WB2CBA/QO100-PORTABLE-TRANSCEIVER-PROJECT/QO100 PA/QO100_PA.kicad_pcb

## KiCad design QO100 PA/QO100_PA.kicad_pcb (2024-05-10)

Schematic: QO100_PA.sch, N3B QO100 TRX PA + PSU

Parts:
C1: 100uF/50V; CP_Elec_6.3x7.7
C2: 1000uF/16V; CP_Elec_10x10.5
D1, D3: SS34; D_SMA
D2: PWR; LED_D3.0mm
H1, H2, H3, H4: MountingHole_Pad; MountingHole_3.2mm_M3_DIN965_Pad
J1: PATCH01; PinHeader_1x20_P2.54mm_Vertical
J2: PATCH02; PinHeader_1x20_P2.54mm_Vertical
J3: PJ-102A; Barrel_Jack_5.5mmODx2.1mmID_PJ-102A; MPN PJ-102A; Digi-Key_PN CP-102A-ND
J4: EDUP PWR; PinHeader_1x02_P2.54mm_Vertical
L1: 100uH; L_Bourns-SRN8040_8x8.15mm-MOD
R1: 1k; R_0805_2012Metric
SW1: POWER SW; EG1206
U1: SKY65135Module; SKY65135_MODULE
U2: LM2576S-5; TO-263-5_TabPin3

Connections:
+5V: C2.1, J1.9, L1.2, U1.2, U1.3, U2.4 (FB)
+12V: C1.1, J1.8, J4.1, R1.1, SW1.2 (B), U2.1 (VIN)
GNDPWR: C1.2, C2.2, D2.1 (K), D3.2 (A), H1.1, H2.1, H3.1, H4.1, J1.18, J1.19, J1.20, J2.18, J2.19, J2.20, J3.2, J3.3, J4.2, U1.4, U1.5, U1.6, U2.3 (GND), U2.5 (~ON~/OFF)
unnamed: D1.1 (K), SW1.3 (C)
unnamed: D1.2 (A), J3.1
unnamed: D2.2 (A), R1.2
unnamed: D3.1 (K), L1.1, U2.2 (OUT)

Notes on the sheet:
PSU Unit

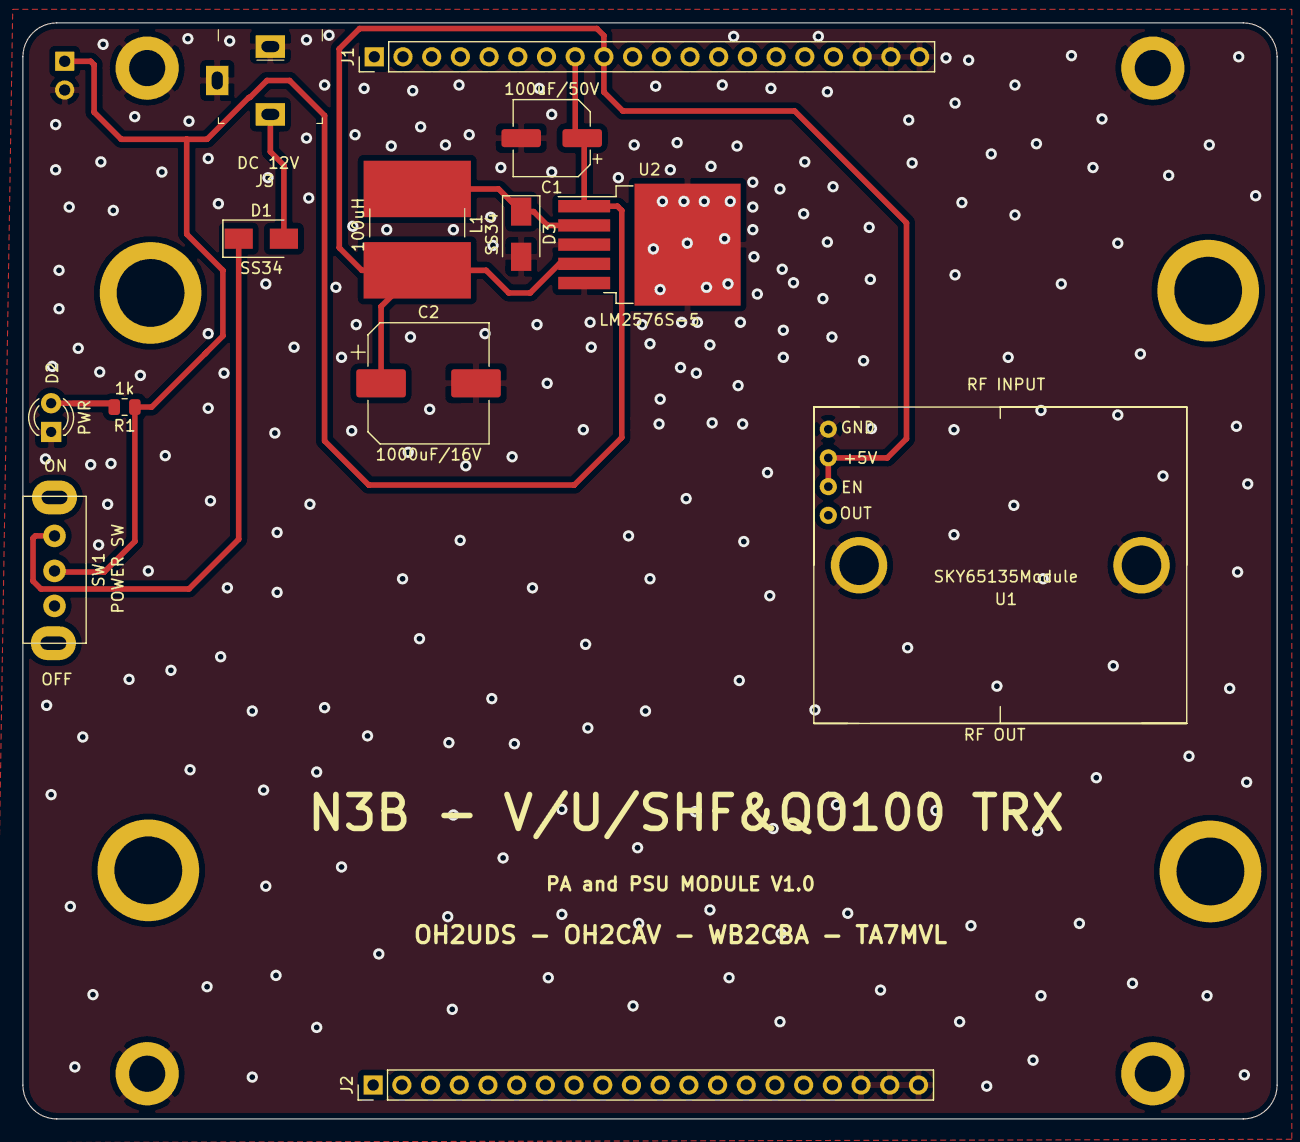
[picture p1: board QO100_PA.kicad_pcb from above]

Board: 2 copper layers, 111.0 x 97.0 mm, 18 parts (1 on the bottom side), 7 nets.
