WB2CBA/QO100-PORTABLE-TRANSCEIVER-PROJECT/QO100 RX MODULE/QO100_RX.kicad_pcb

## KiCad design QO100 RX MODULE/QO100_RX.kicad_pcb (2024-04-22)

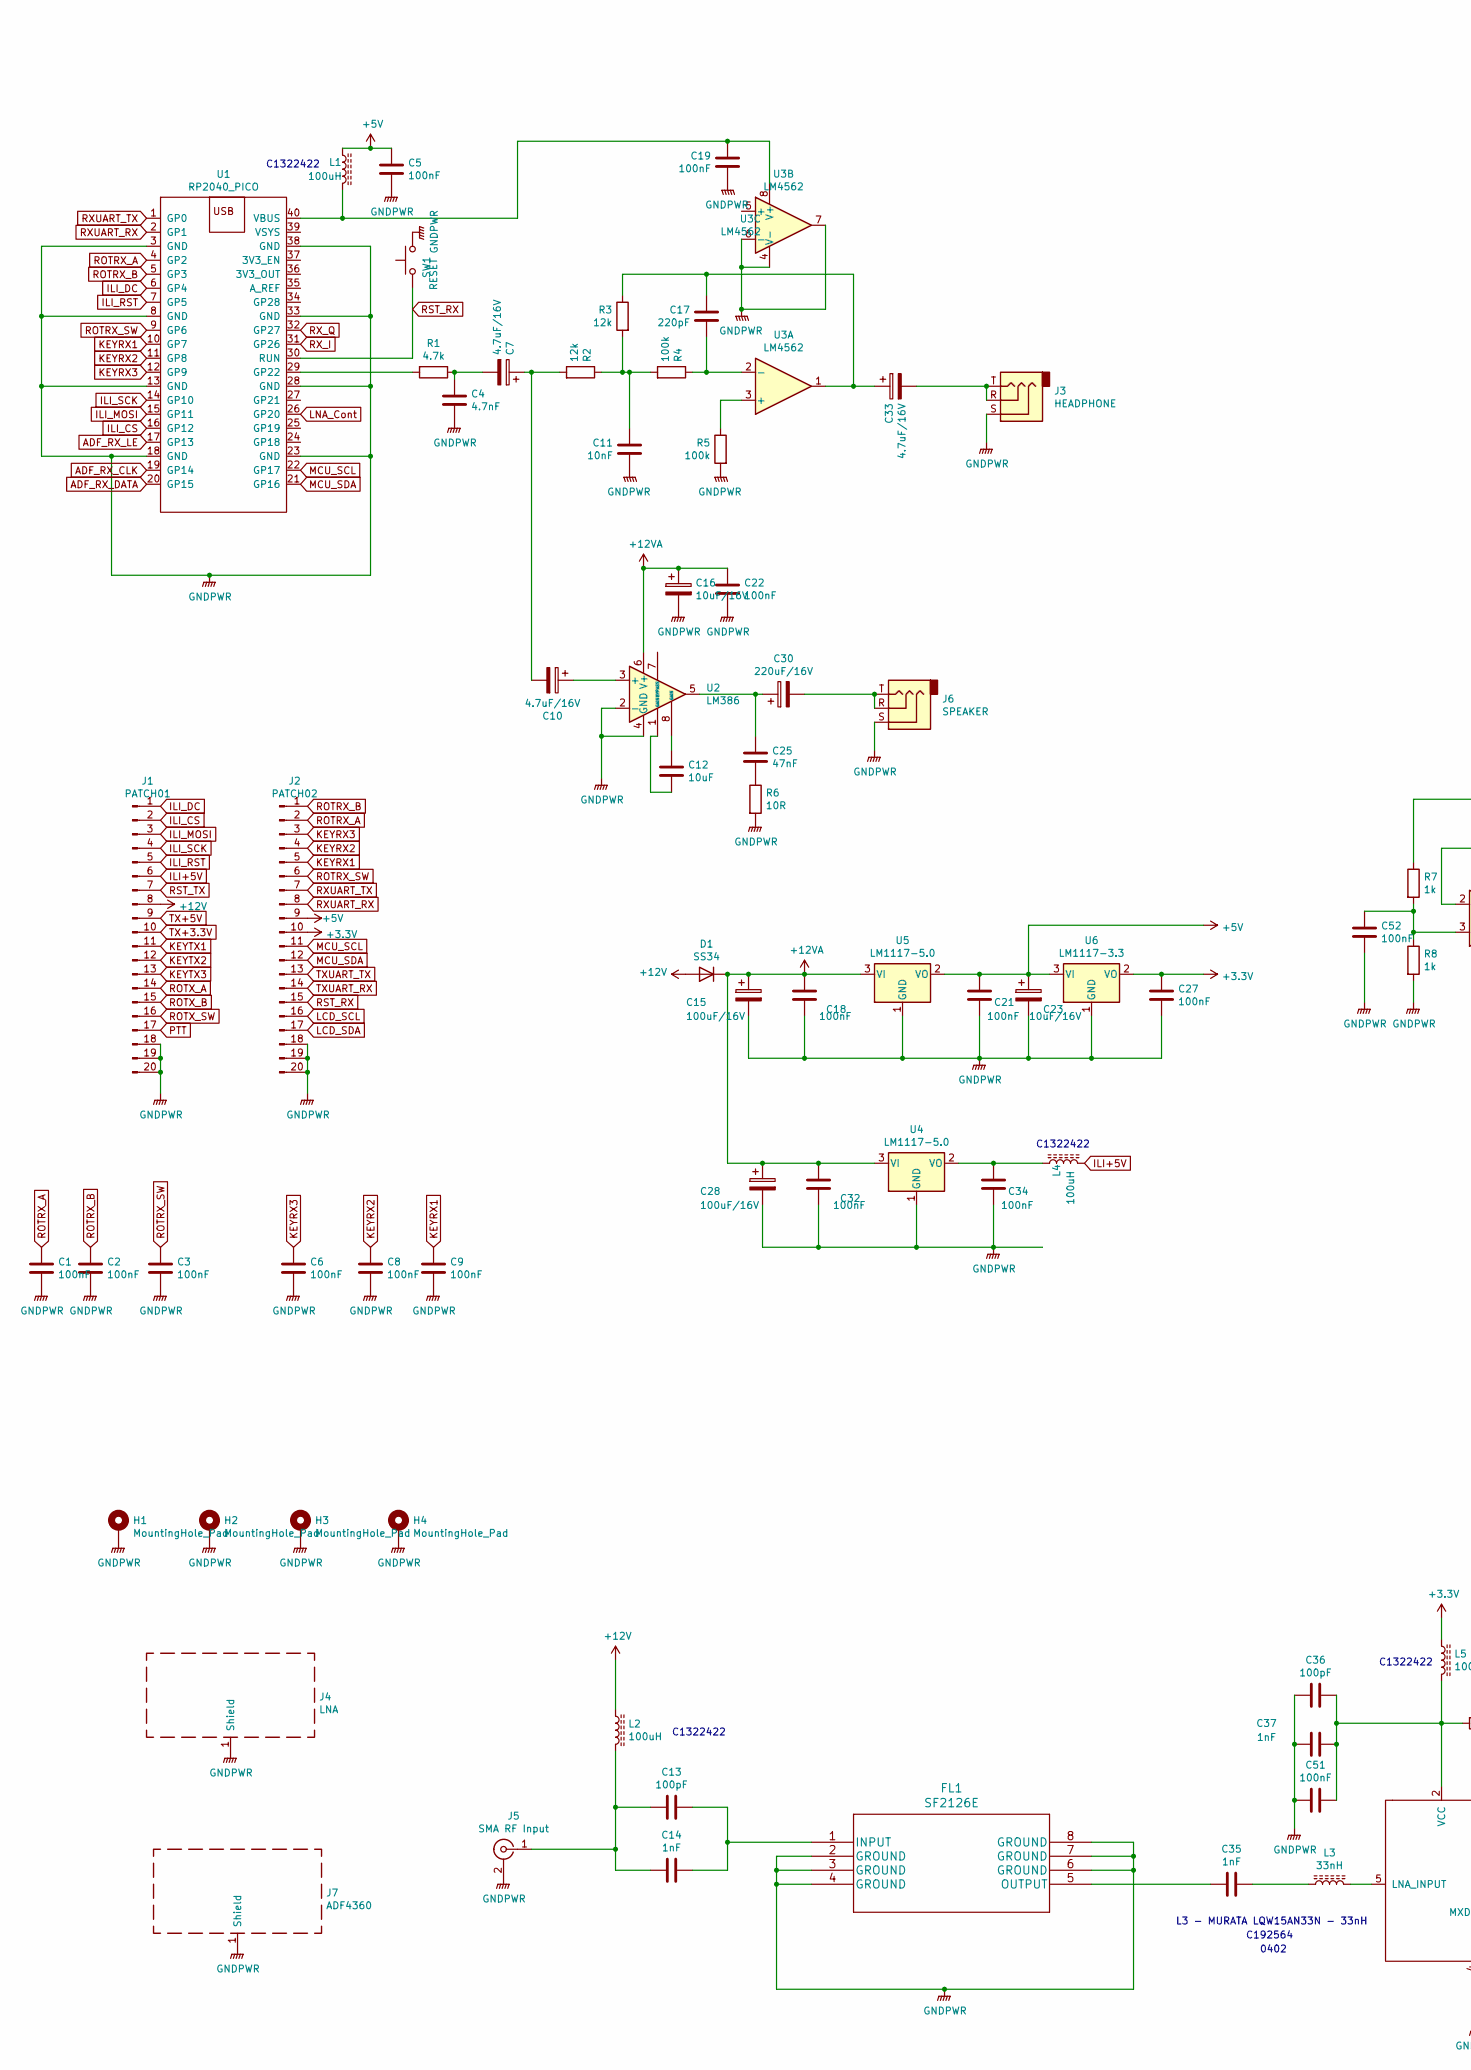
[picture p2: schematic QO100_RX.sch, N3B QO100 RX MODULE, part in row 1, column 1]

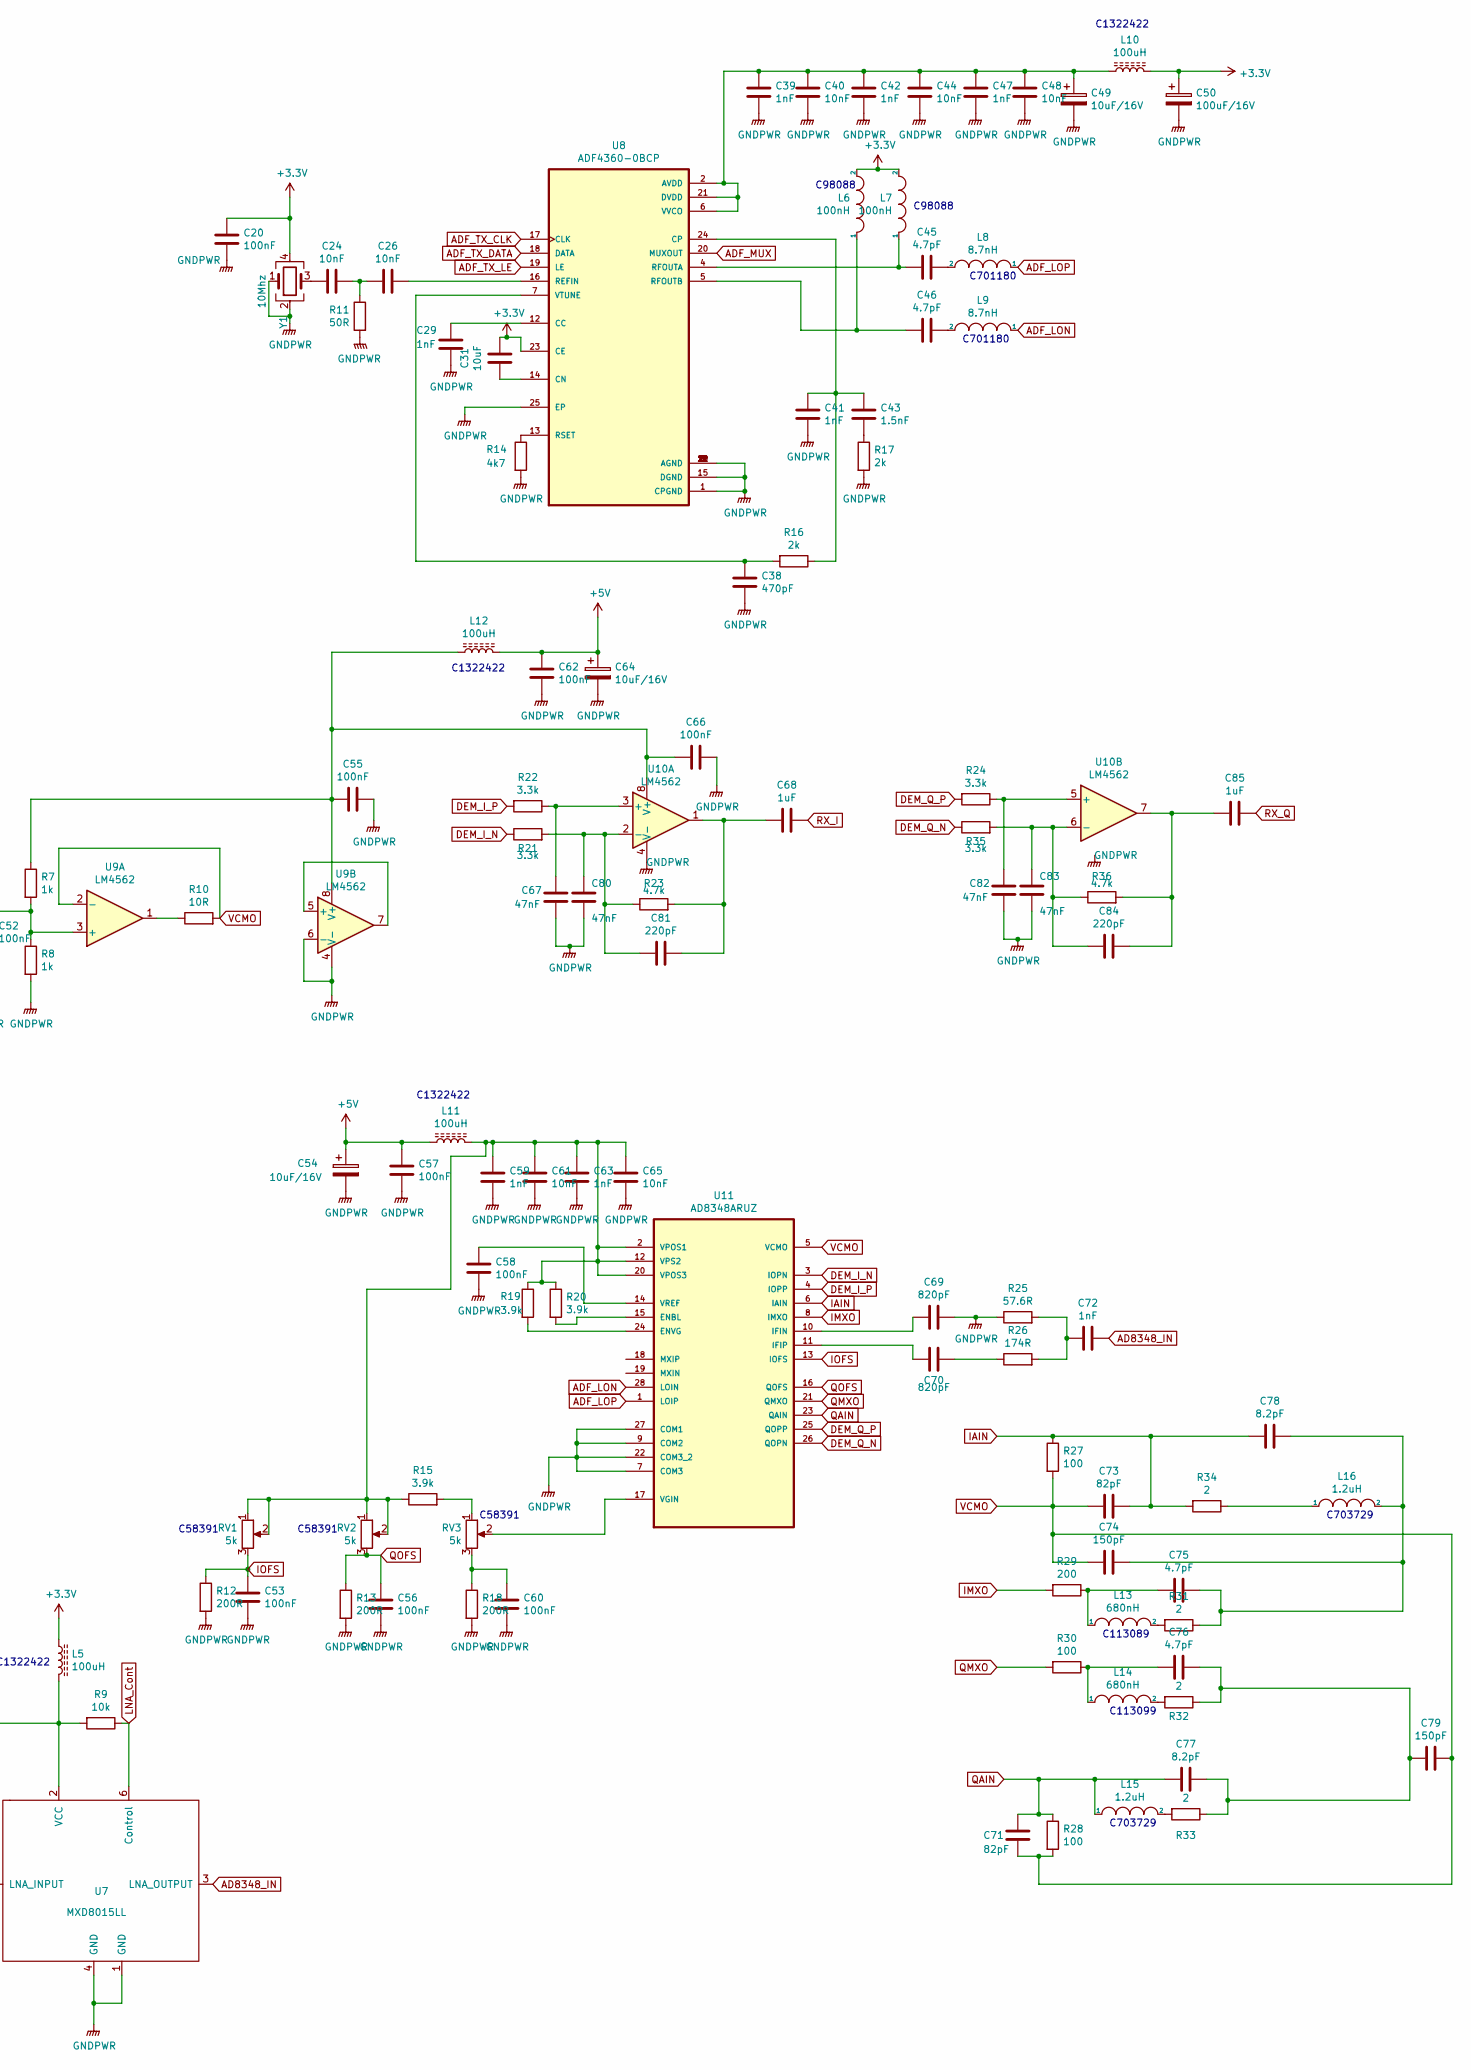
[picture p3: schematic QO100_RX.sch, N3B QO100 RX MODULE, part in row 1, column 2]

Parts:
C1, C2, C3, C5, C6, C8, C9, C18, C19, C20, C21, C22, C27, C32, C34, C51, C52, C53, C55, C56, C57, C58, C60, C62, C66: 100nF; C_0805_2012Metric
C4: 4.7nF; C_0805_2012Metric
C7, C10, C33: 4.7uF/16V; CP_Elec_4x5.4
C11, C24, C26, C40, C44, C48, C61, C65: 10nF; C_0805_2012Metric
C12, C31: 10uF; C_0805_2012Metric
C13, C36: 100pF; C_0805_2012Metric
C14, C29, C35, C37, C39, C41, C42, C47, C59, C63, C72: 1nF; C_0805_2012Metric
C15, C28, C50: 100uF/16V; CP_Elec_6.3x7.7
C16, C23, C49, C54, C64: 10uF/16V; CP_Elec_4x5.4
C17, C81, C84: 220pF; C_0805_2012Metric
C25, C67, C80, C82, C83: 47nF; C_0805_2012Metric
C30: 220uF/16V; CP_Elec_6.3x7.7
C38: 470pF; C_0805_2012Metric
C43: 1.5nF; C_0805_2012Metric
C45, C46, C75, C76: 4.7pF; C_0805_2012Metric
C68, C85: 1uF; C_0805_2012Metric
C69, C70: 820pF; C_0805_2012Metric
C71, C73: 82pF; C_0805_2012Metric
C74, C79: 150pF; C_0805_2012Metric
C77, C78: 8.2pF; C_0805_2012Metric
D1: SS34; D_SMA
FL1: SF2126E
H1, H2, H3, H4: MountingHole_Pad; MountingHole_3.2mm_M3_DIN965_Pad
J1: PATCH01; PinHeader_1x20_P2.54mm_Vertical
J2: PATCH02; PinHeader_1x20_P2.54mm_Vertical
J3: HEADPHONE; Jack_3.5mm_PJ-320B-SMT_Horizontal_CORR
J4: LNA; Laird_Technologies_BMI-S-102_16.50x16.50mm
J5: SMA RF Input; SMA_Samtec_SMA-J-P-X-ST-EM1_EdgeMount
J6: SPEAKER; Jack_3.5mm_PJ-320B-SMT_Horizontal_CORR
J7: ADF4360; Laird_Technologies_BMI-S-204-F_32.00x32.00mm
L1, L2, L4, L5, L10, L11, L12: 100uH; L_1210_3225Metric
L3: 33nH; L_0402_1005Metric
L6, L7: 100nH; L_0603_1608Metric
L8, L9: 8.7nH; L_0603_1608Metric
L13, L14: 680nH; L_0805_2012Metric
L15, L16: 1.2uH; L_0805_2012Metric
R1, R23, R36: 4.7k; R_0805_2012Metric
R2, R3: 12k; R_0805_2012Metric
R4, R5: 100k; R_0805_2012Metric
R6, R10: 10R; R_0805_2012Metric
R7, R8: 1k; R_0805_2012Metric
R9: 10k; R_0805_2012Metric
R11: 50R; R_0805_2012Metric
R12, R13, R18: 200R; R_0805_2012Metric
R14: 4k7; R_0805_2012Metric
R15, R19, R20: 3.9k; R_0805_2012Metric
R16, R17: 2k; R_0805_2012Metric
R21, R22, R24, R35: 3.3k; R_0805_2012Metric
R25: 57.6R; R_0805_2012Metric
R26: 174R; R_0805_2012Metric
R27, R28, R30: 100; R_0805_2012Metric
R29: 200; R_0805_2012Metric
R31, R32, R33, R34: 2; R_0805_2012Metric
RV1, RV2, RV3: 5k; Potentiometer_Bourns_3314J_Vertical
SW1: RESET; SW_Push_1P1T_NO_6x6mm_H9.5mm
U1: RP2040_PICO; RPI2040_PICO_SMD
U2: LM386; SO-8_3.9x4.9mm_P1.27mm
U3, U9, U10: LM4562; SO-8_3.9x4.9mm_P1.27mm
U4, U5: LM1117-5.0; SOT-223-3_TabPin2
U6: LM1117-3.3; SOT-223-3_TabPin2
U7: MXD8015LL; IC_BGC100GN6E6327XTSA1
U8: ADF4360-0BCP; ADF4360SEDA
U11: AD8348ARUZ; AD8348SEDA; MPN AD8348ARUZ
Y1: 10Mhz; Crystal_SMD_SeikoEpson_FA238V-4Pin_3.2x2.5mm

Connections:
+3V3: C20.1, C27.1, C31.1, C50.1, J2.10, L5.1, L6.2, L7.2, L10.2, U6.2 (VO), U8.23 (CE), Y1.4
+5V: C5.1, C21.1, C23.1, C54.1, C57.1, C62.1, C64.1, J2.9, L1.1, L11.1, L12.2, U5.2 (VO), U6.3 (VI)
+12V: D1.2 (A), J1.8, L2.1
+12VA: C15.1, C16.1, C18.1, C22.1, C28.1, C32.1, D1.1 (K), U2.6 (V+), U4.3 (VI), U5.3 (VI)
AD8348_IN: C72.2, U7.3 (LNA_OUTPUT)
ADF_LON: L9.1, U11.28 (LOIN)
ADF_LOP: L8.1, U11.1 (LOIP)
ADF_MUX: U8.20 (MUXOUT)
ADF_RX_CLK: U1.19 (GP14)
ADF_RX_DATA: U1.20 (GP15)
ADF_RX_LE: U1.17 (GP13)
ADF_TX_CLK: U8.17 (CLK)
ADF_TX_DATA: U8.18 (DATA)
ADF_TX_LE: U8.19 (LE)
DEM_I_N: R21.1, U11.3 (IOPN)
DEM_I_P: R22.2, U11.4 (IOPP)
DEM_Q_N: R35.1, U11.26 (QOPN)
DEM_Q_P: R24.2, U11.25 (QOPP)
GNDPWR: C1.2, C2.2, C3.2, C4.2, C5.2, C6.2, C8.2, C9.2, C11.2, C15.2, C16.2, C18.2, C19.2, C20.2, C21.2, C22.2, C23.2, C27.2, C28.2, C29.2, C32.2, C34.2, C36.2, C37.2, C38.2, C39.2, C40.2, C41.2, C42.2, C44.2, C47.2, C48.2, C49.2, C50.2, C51.2, C52.2, C53.2, C54.2, C55.2, C56.2, C57.2, C58.2, C59.2, C60.2, C61.2, C62.2, C63.2, C64.2, C65.2, C66.1, C67.2, C69.2, C80.2, C82.2, C83.2, FL1.2 (GROUND), FL1.3 (GROUND), FL1.4 (GROUND), FL1.6 (GROUND), FL1.7 (GROUND), FL1.8 (GROUND), H1.1, H2.1, H3.1, H4.1, J1.18, J1.19, J1.20, J2.18, J2.19, J2.20, J3.S, J4.1, J5.2 (Ext), J6.S, J7.1, R5.2, R6.2, R8.2, R11.2, R12.2, R13.2, R14.2, R17.2, R18.2, R25.1, SW1.2, U1.3 (GND), U1.8 (GND), U1.13 (GND), U1.18 (GND), U1.23 (GND), U1.28 (GND), U1.33 (GND), U1.38 (GND), U2.2 (-), U2.4 (GND), U3.4 (V-), U3.6 (-), U3.7, U4.1 (GND), U5.1 (GND), U6.1 (GND), U7.1 (GND), U7.4 (GND), U8.1 (CPGND), U8.3 (AGND), U8.8 (AGND), U8.9 (AGND), U8.10 (AGND), U8.11 (AGND), U8.15 (DGND), U8.22 (AGND), U8.25 (EP), U9.4 (V-), U9.6 (-), U10.4 (V-), U11.7 (COM3), U11.9 (COM2), U11.22 (COM3_2), U11.27 (COM1), Y1.1, Y1.2
IAIN: C73.1, C78.2, R27.1, R34.2, U11.6 (IAIN)
ILI+5V: J1.6, L4.2
ILI_CS: J1.2, U1.16 (GP12)
ILI_DC: J1.1, U1.6 (GP4)
ILI_MOSI: J1.3, U1.15 (GP11)
ILI_RST: J1.5, U1.7 (GP5)
ILI_SCK: J1.4, U1.14 (GP10)
IMXO: R29.2, U11.8 (IMXO)
IOFS: C53.1, R12.1, RV1.3, U11.13 (IOFS)
KEYRX1: C9.1, J2.5, U1.10 (GP7)
KEYRX2: C8.1, J2.4, U1.11 (GP8)
KEYRX3: C6.1, J2.3, U1.12 (GP9)
KEYTX1: J1.11
KEYTX2: J1.12
KEYTX3: J1.13
LCD_SCL: J2.16
LCD_SDA: J2.17
LNA_Cont: R9.1, U1.26 (GP20), U7.6 (Control)
MCU_SCL: J2.11, U1.22 (GP17)
MCU_SDA: J2.12, U1.21 (GP16)
unnamed: C4.1, C7.2, R1.1
unnamed: C10.1, U2.3 (+)
unnamed: C7.1, C10.2, R2.2
unnamed: C11.1, R2.1, R3.2, R4.2
unnamed: C12.1, U2.8 (GAIN)
unnamed: C12.2, U2.1 (GAIN)
unnamed: C13.1, C14.1, FL1.1 (INPUT)
unnamed: C13.2, C14.2, J5.1 (In), L2.2
unnamed: C17.1, C33.1, R3.1, U3.1
unnamed: C17.2, R4.1, U3.2 (-)
unnamed: C19.1, L1.2, U1.40 (VBUS), U3.8 (V+)
unnamed: C24.1, Y1.3
unnamed: C24.2, C26.1, R11.1
unnamed: C25.1, C30.1, U2.5
unnamed: C25.2, R6.1
unnamed: C26.2, U8.16 (REFIN)
unnamed: C29.1, U8.12 (CC)
unnamed: C30.2, J6.R, J6.T
unnamed: C31.2, U8.14 (CN)
unnamed: C33.2, J3.R, J3.T
unnamed: C34.1, L4.1, U4.2 (VO)
unnamed: C35.1, L3.1
unnamed: C35.2, FL1.5 (OUTPUT)
unnamed: C36.1, C37.1, C51.1, L5.2, R9.2, U7.2 (VCC)
unnamed: C38.1, R16.2, U8.7 (VTUNE)
unnamed: C39.1, C40.1, C42.1, C44.1, C47.1, C48.1, C49.1, L10.1, U8.2 (AVDD), U8.6 (VVCO), U8.21 (DVDD)
unnamed: C41.1, C43.1, R16.1, U8.24 (CP)
unnamed: C43.2, R17.1
unnamed: C45.1, L7.1, U8.4 (RFOUTA)
unnamed: C45.2, L8.2
unnamed: C46.1, L6.1, U8.5 (RFOUTB)
unnamed: C46.2, L9.2
unnamed: C52.1, R7.2, R8.1, U9.3 (+)
unnamed: C55.1, C66.2, L12.1, R7.1, U9.8 (V+), U10.8 (V+)
unnamed: C58.1, U11.14 (VREF)
unnamed: C59.1, C61.1, C63.1, C65.1, L11.2, R15.1, R19.1, R20.1, RV1.1, RV1.2, RV2.1, RV2.2, U11.2 (VPOS1), U11.12 (VPS2), U11.20 (VPOS3)
unnamed: C60.1, R18.1, RV3.3
unnamed: C67.1, R22.1, U10.3 (+)
unnamed: C68.2, C81.1, R23.2, U10.1
unnamed: C69.1, U11.10 (IFIN)
unnamed: C70.1, U11.11 (IFIP)
unnamed: C70.2, R26.1
unnamed: C72.1, R25.2, R26.2
unnamed: C74.1, C75.2, C78.1, L16.2, R31.1
unnamed: C75.1, L13.1, R29.1
unnamed: C76.1, L14.1, R30.1
unnamed: C76.2, C77.2, C79.1, R32.1, R33.1
unnamed: C80.1, C81.2, R21.2, R23.1, U10.2 (-)
unnamed: C82.1, R24.1, U10.5 (+)
unnamed: C83.1, C84.2, R35.2, R36.1, U10.6 (-)
unnamed: C84.1, C85.2, R36.2, U10.7
unnamed: L3.2, U7.5 (LNA_INPUT)
unnamed: L13.2, R31.2
unnamed: L14.2, R32.2
unnamed: L15.2, R33.2
unnamed: L16.1, R34.1
unnamed: R1.2, U1.29 (GP22)
unnamed: R5.1, U3.3 (+)
unnamed: R10.1, U9.1
unnamed: R14.1, U8.13 (RSET)
unnamed: R15.2, RV3.1
unnamed: R19.2, U11.24 (ENVG)
unnamed: R20.2, U11.15 (ENBL)
unnamed: RV3.2, U11.17 (VGIN)
unnamed: U9.5 (+), U9.7
PTT: J1.17
QAIN: C71.1, C77.1, L15.1, R28.1, U11.23 (QAIN)
QMXO: R30.2, U11.21 (QMXO)
QOFS: C56.1, R13.1, RV2.3, U11.16 (QOFS)
ROTRX_A: C1.1, J2.2, U1.4 (GP2)
ROTRX_B: C2.1, J2.1, U1.5 (GP3)
ROTRX_SW: C3.1, J2.6, U1.9 (GP6)
ROTX_A: J1.14
ROTX_B: J1.15
ROTX_SW: J1.16
RST_RX: J2.15, SW1.1, U1.30 (RUN)
RST_TX: J1.7
RXUART_RX: J2.8, U1.2 (GP1)
RXUART_TX: J2.7, U1.1 (GP0)
RX_I: C68.1, U1.31 (GP26)
RX_Q: C85.1, U1.32 (GP27)
TX+3.3V: J1.10
TX+5V: J1.9
TXUART_RX: J2.14
TXUART_TX: J2.13
VCMO: C71.2, C73.2, C74.2, C79.2, R10.2, R27.2, R28.2, U9.2 (-), U11.5 (VCMO)

Notes on the sheet:
L3 - MURATA LQW15AN33N - 33nH
C192564
0402
C113089
C113099
C703729
C1322422
C701180
C98088
C58391

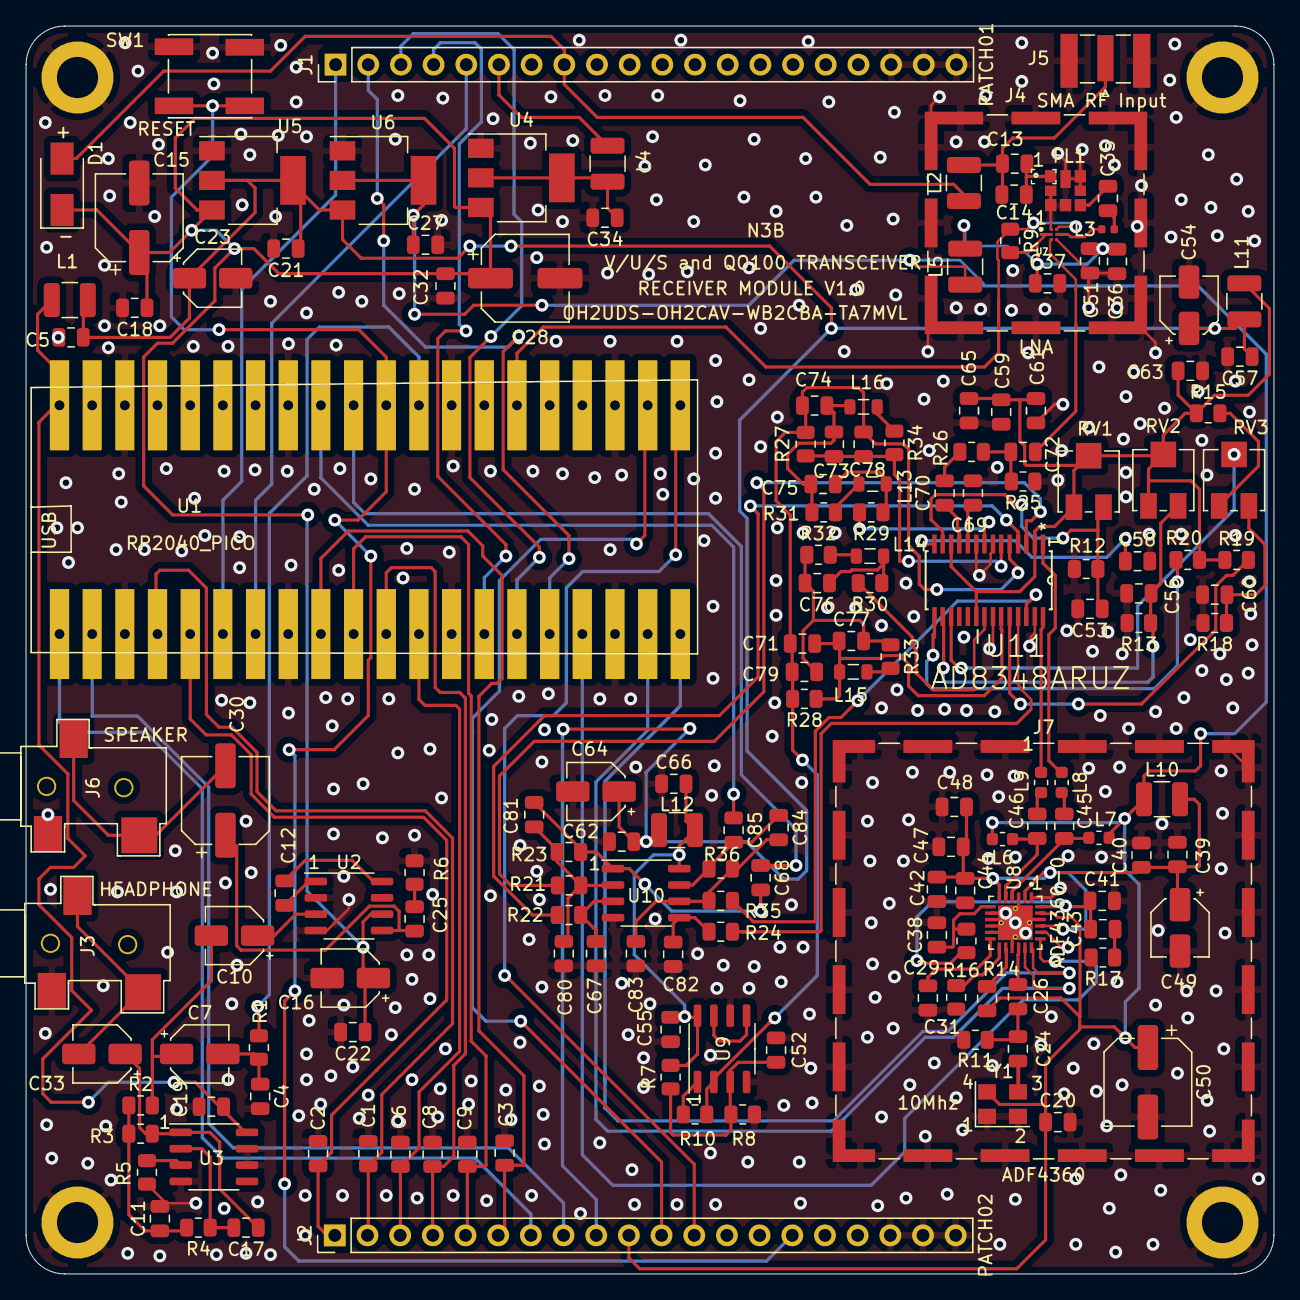
[picture p4: board QO100_RX.kicad_pcb from above]

Board: 2 copper layers, 97.0 x 97.0 mm, 166 parts (0 on the bottom side), 104 nets.
