WB2CBA/QO100-PORTABLE-TRANSCEIVER-PROJECT/QO100 TRX KEYBOARD AND DISPLAY INTERFACE/QO100_TX.kicad_pcb

## KiCad design QO100 TRX KEYBOARD AND DISPLAY INTERFACE/QO100_TX.kicad_pcb (2024-04-22)

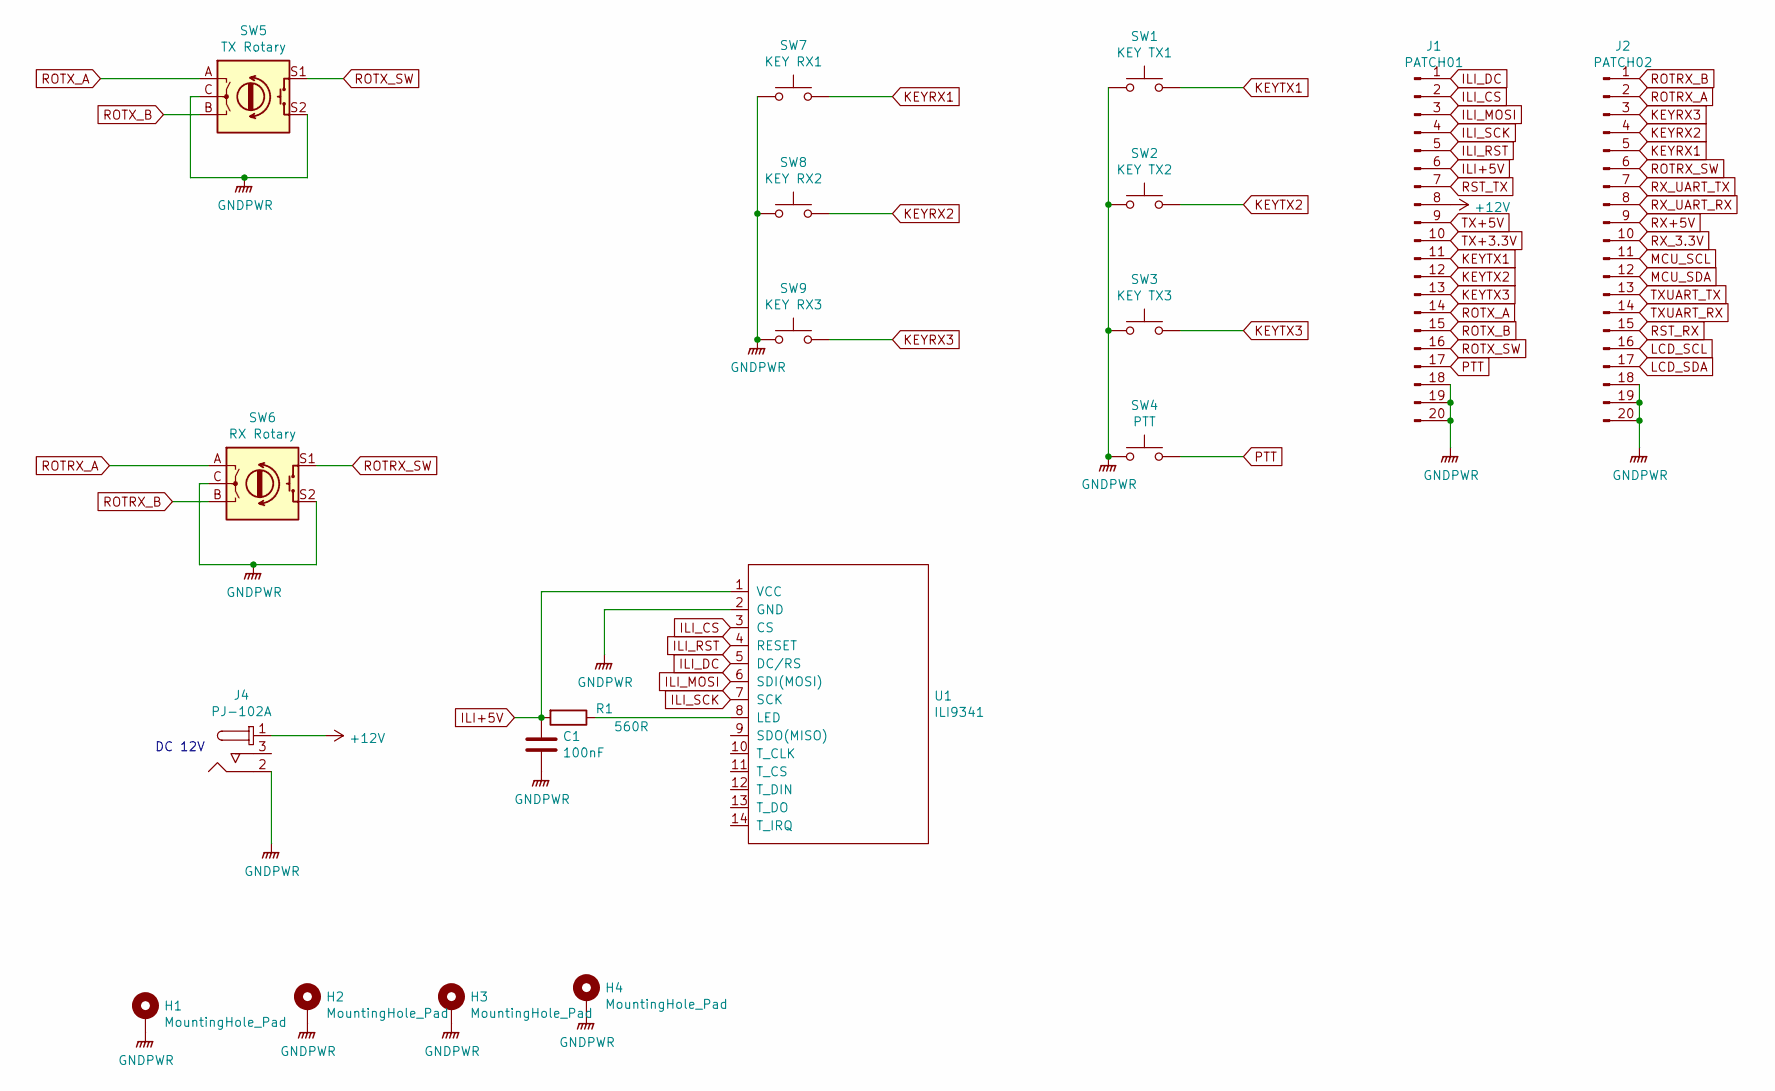
[picture p5: schematic QO100_TX.sch, N3B QO100 RX/TX Keyboard and TFT Display Interface]

Parts:
C1: 100nF; C_Disc_D3.0mm_W1.6mm_P2.50mm
H1, H2, H3, H4: MountingHole_Pad; MountingHole_3.2mm_M3_DIN965_Pad
J1: PATCH01; PinHeader_1x20_P2.54mm_Vertical
J2: PATCH02; PinHeader_1x20_P2.54mm_Vertical
J4: PJ-102A; Barrel_Jack_5.5mmODx2.1mmID_PJ-102A; MPN PJ-102A; Digi-Key_PN CP-102A-ND
R1: 560R; R_Axial_DIN0207_L6.3mm_D2.5mm_P7.62mm_Horizontal
SW1: KEY TX1; SW_PUSH_6mm
SW2: KEY TX2; SW_PUSH_6mm
SW3: KEY TX3; SW_PUSH_6mm
SW4: PTT; SW_PUSH_6mm
SW5: TX Rotary; RotaryEncoder_Alps_EC11E-Switch_Vertical_H20mm
SW6: RX Rotary; RotaryEncoder_Alps_EC11E-Switch_Vertical_H20mm
SW7: KEY RX1; SW_PUSH_6mm
SW8: KEY RX2; SW_PUSH_6mm
SW9: KEY RX3; SW_PUSH_6mm
U1: ILI9341; ILI9341_32

Connections:
+12V: J1.8, J4.1
GNDPWR: C1.2, H1.1, H2.1, H3.1, H4.1, J1.18, J1.19, J1.20, J2.18, J2.19, J2.20, J4.2, SW1.1, SW2.1, SW3.1, SW4.1, SW5.C, SW5.S2, SW6.C, SW6.S2, SW7.1, SW8.1, SW9.1, U1.2 (GND)
ILI+5V: C1.1, J1.6, R1.2, U1.1 (VCC)
ILI_CS: J1.2, U1.3 (CS)
ILI_DC: J1.1, U1.5 (DC/RS)
ILI_MOSI: J1.3, U1.6 (SDI(MOSI))
ILI_RST: J1.5, U1.4 (RESET)
ILI_SCK: J1.4, U1.7 (SCK)
KEYRX1: J2.5, SW7.2
KEYRX2: J2.4, SW8.2
KEYRX3: J2.3, SW9.2
KEYTX1: J1.11, SW1.2
KEYTX2: J1.12, SW2.2
KEYTX3: J1.13, SW3.2
LCD_SCL: J2.16
LCD_SDA: J2.17
MCU_SCL: J2.11
MCU_SDA: J2.12
unnamed: R1.1, U1.8 (LED)
PTT: J1.17, SW4.2
ROTRX_A: J2.2, SW6.A
ROTRX_B: J2.1, SW6.B
ROTRX_SW: J2.6, SW6.S1
ROTX_A: J1.14, SW5.A
ROTX_B: J1.15, SW5.B
ROTX_SW: J1.16, SW5.S1
RST_RX: J2.15
RST_TX: J1.7
RX+5V: J2.9
RX_3.3V: J2.10
RX_UART_RX: J2.8
RX_UART_TX: J2.7
TX+3.3V: J1.10
TX+5V: J1.9
TXUART_RX: J2.14
TXUART_TX: J2.13

Notes on the sheet:
DC 12V

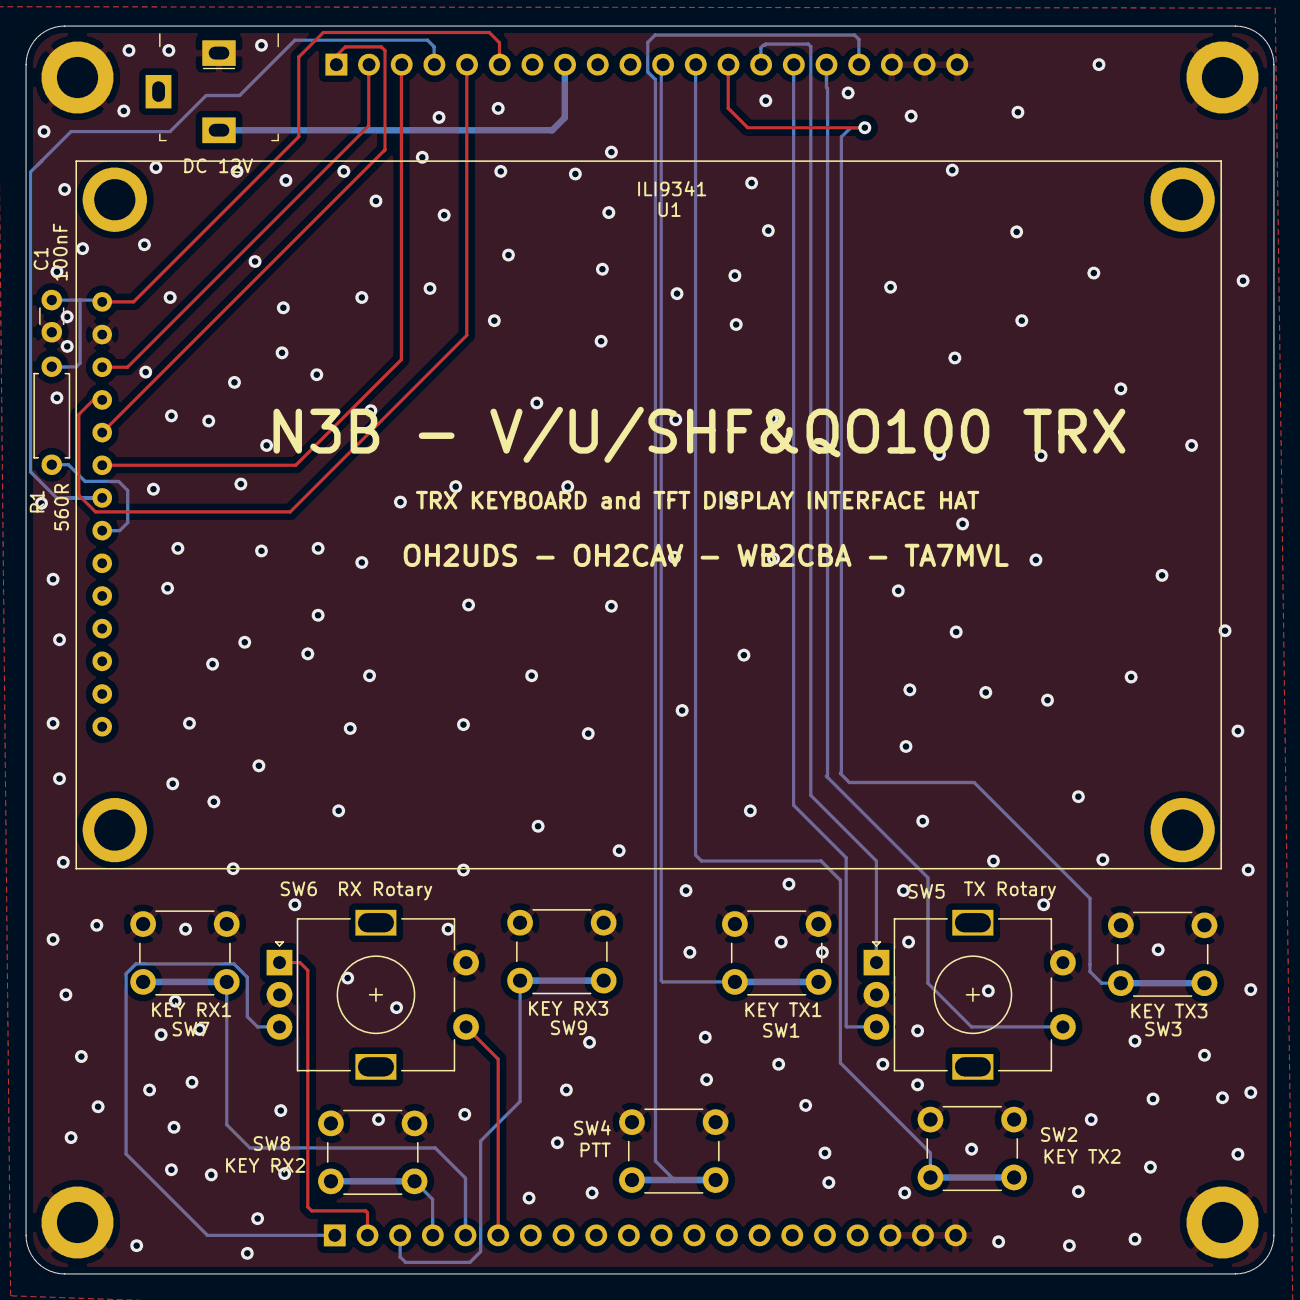
[picture p6: board QO100 TRX KEYBOARD AND DISPLAY INTERFACE/QO100_TX.kicad_pcb from above]

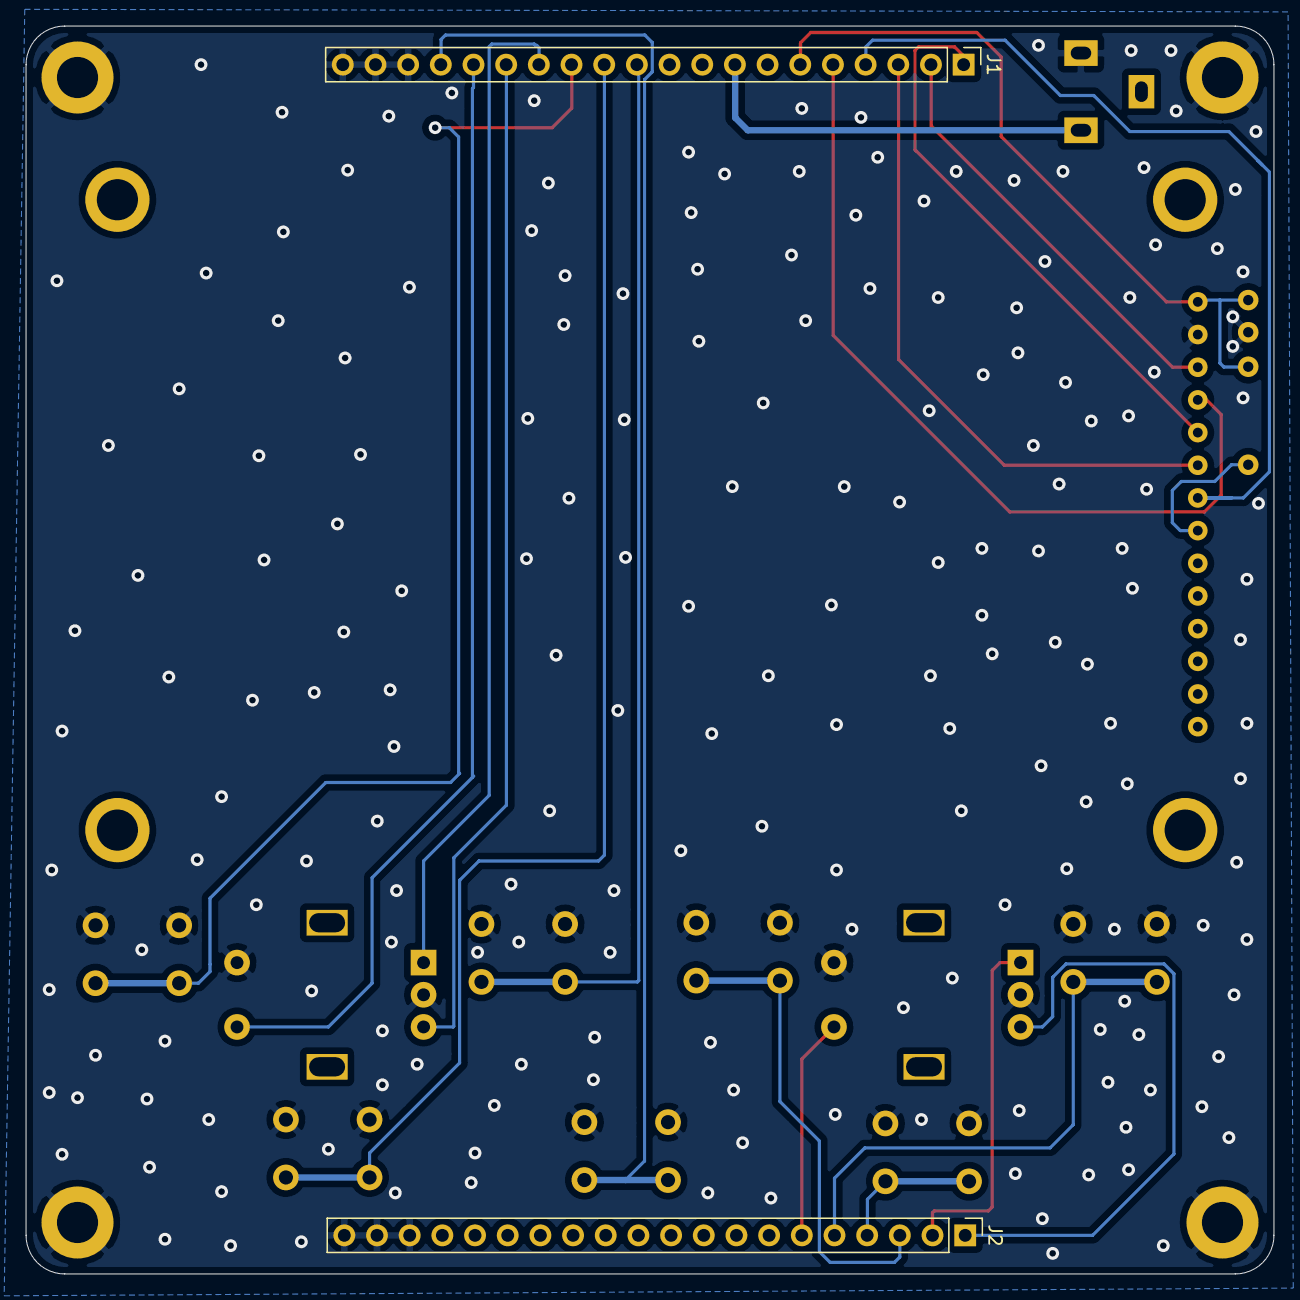
[picture p7: board QO100 TRX KEYBOARD AND DISPLAY INTERFACE/QO100_TX.kicad_pcb from below]

Board: 2 copper layers, 97.0 x 97.0 mm, 19 parts (2 on the bottom side), 22 nets.
